SG-O/MiniFeedPlugBoard_6-13/README.MD

# Mainboard for automated SMT Feeder system #

## Documentation ##

You can find the manufacturing documentation [here.](https://github.com/SG-O/MiniFeedPlugBoard_6-13/tree/master/Doc)

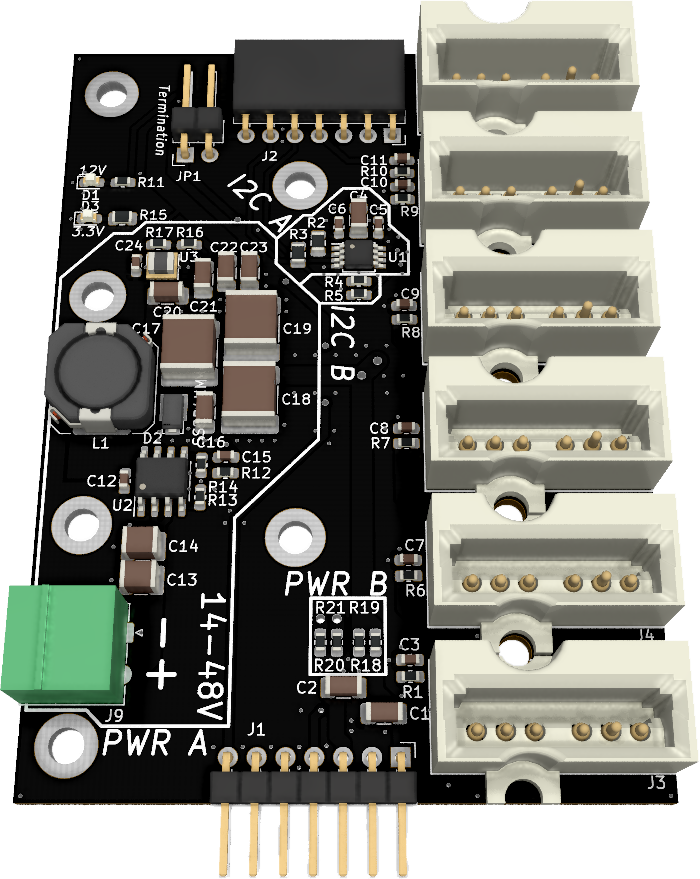
[picture p1: Doc/MiniFeedPlugBoard1.png]
