SG-O/MiniFeedPlugBoard_6-13/Doc/README.MD

# Manufacturing Documentation #

## Schematic ##

You can view the schematic [here.](https://github.com/SG-O/MiniFeedPlugBoard_6-13/blob/master/Doc/MiniFeedPlugBoard.pdf "Schematic")

## Gerber Files ##

Gerber files for this board can be found [here.](https://github.com/SG-O/MiniFeedPlugBoard_6-13/releases "Releases")

## BOM ##

The BOM **without** the power injection circuit and **without** the I2C repeater populated is available [here.](https://github.com/SG-O/MiniFeedPlugBoard_6-13/blob/master/Doc/MiniFeedPlugBoardBOM_pwr_b,i2c_b.csv "No CAN BOM")

The BOM **with** the power injection circuit and **without** the I2C repeater populated is available [here.](https://github.com/SG-O/MiniFeedPlugBoard_6-13/blob/master/Doc/MiniFeedPlugBoardBOM_pwr_a,i2c_b.csv "No CAN BOM")

The BOM **without** the power injection circuit and **with** the I2C repeater populated is available [here.](https://github.com/SG-O/MiniFeedPlugBoard_6-13/blob/master/Doc/MiniFeedPlugBoardBOM_pwr_b,i2c_a.csv "No CAN BOM")

The BOM **with** the power injection circuit and **with** the I2C repeater populated is available [here.](https://github.com/SG-O/MiniFeedPlugBoard_6-13/blob/master/Doc/MiniFeedPlugBoardBOM_pwr_a,i2c_a.csv "No CAN BOM")

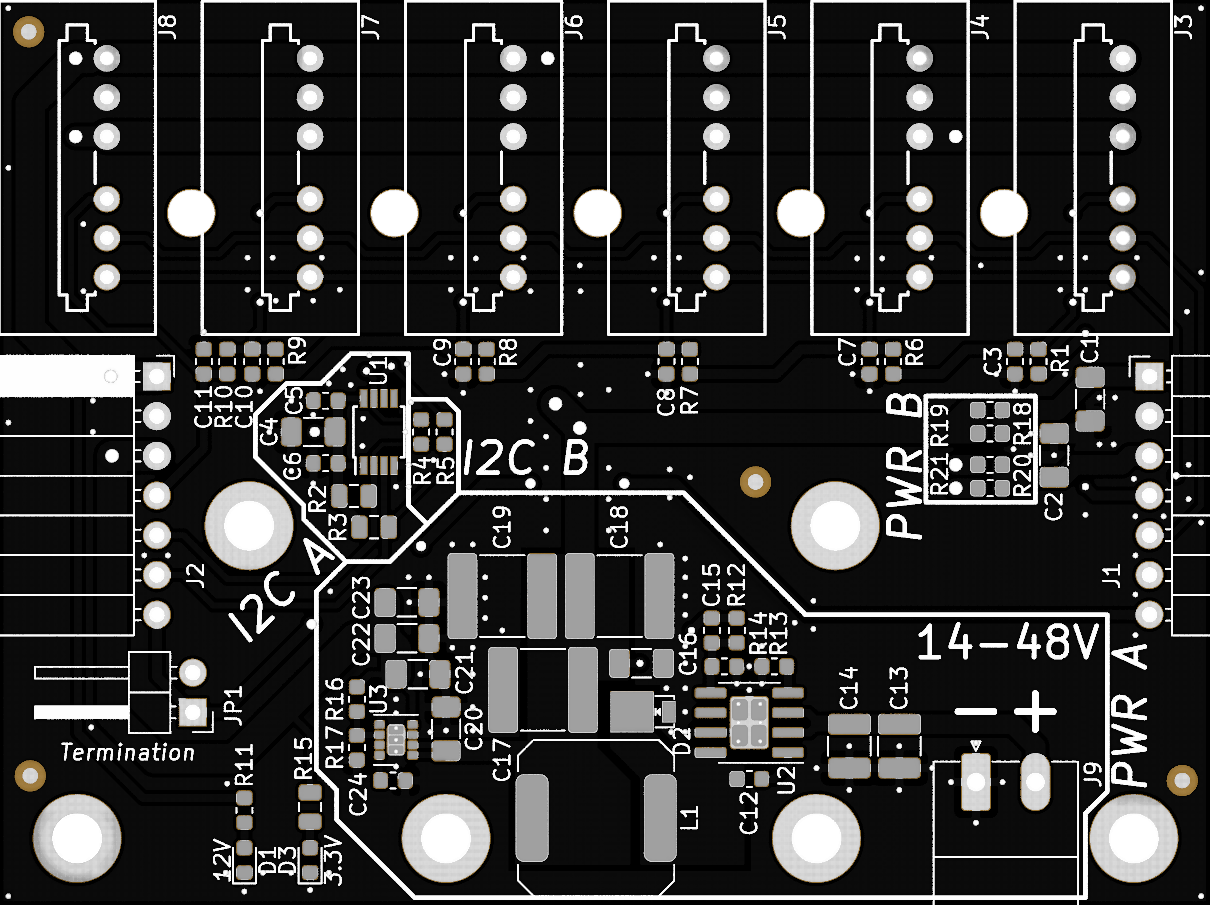
[picture p2: Doc/MiniFeedPlugBoardFront.png]
