SG-O/MiniFeedPlugBoard_6-13/Doc/MiniFeedPlugBoardBack.png

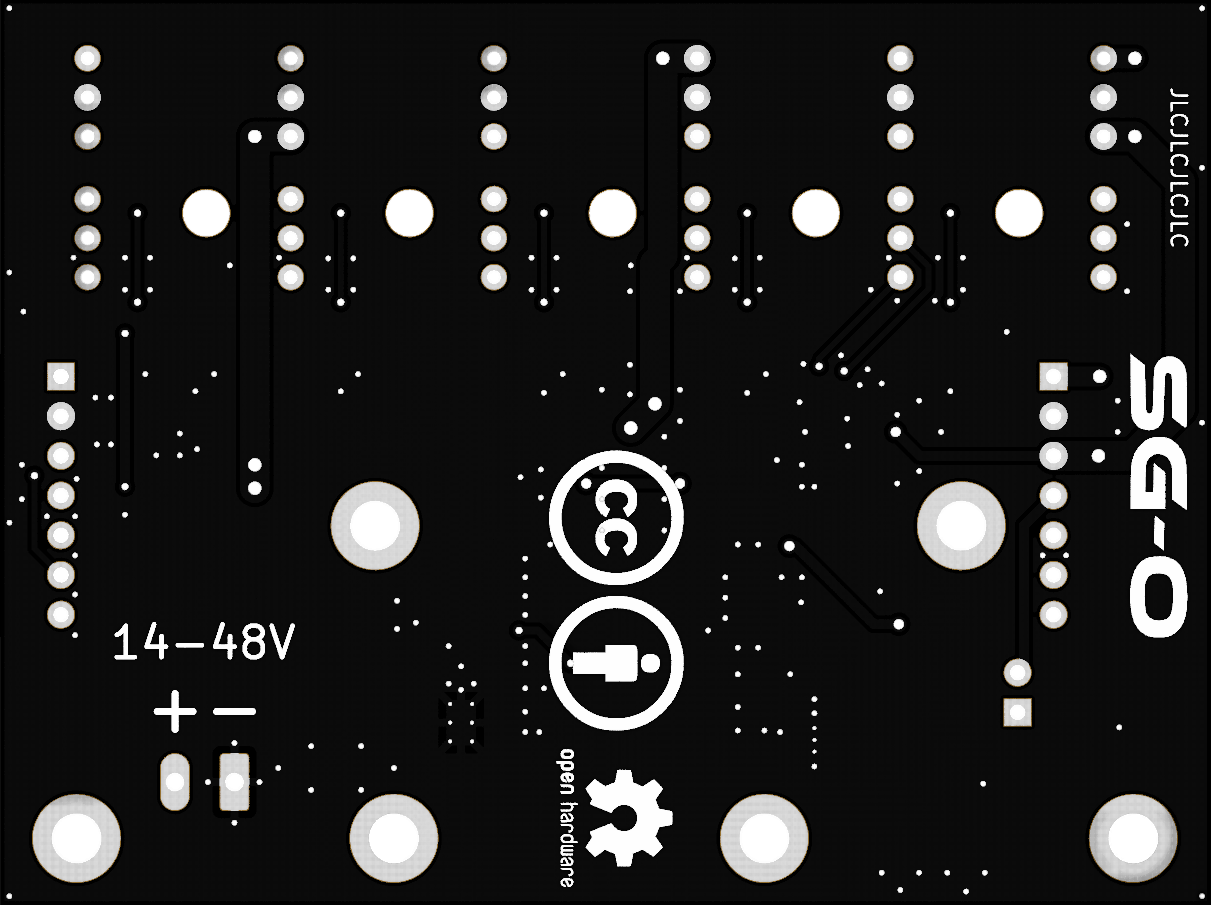
Doc/MiniFeedPlugBoardBack.png
