SG-O/MiniFeedPlugBoard_6-13/Doc/MiniFeedPlugBoard.pdf

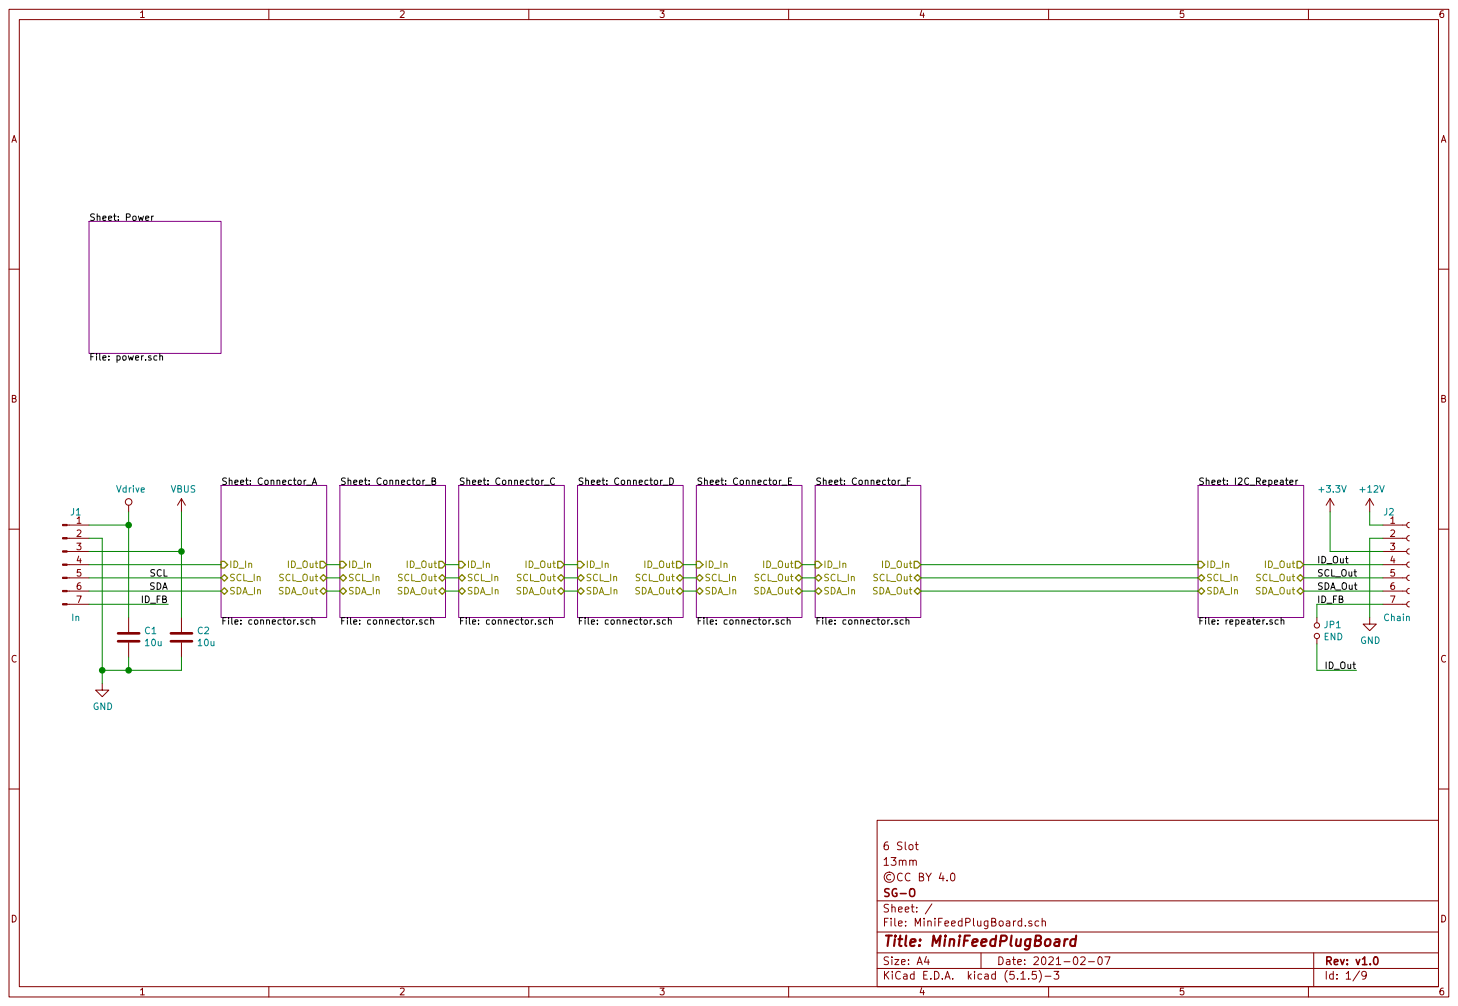
[picture p4: page 1]

File: MiniFeedPlugBoard.sch Sheet: / SG-O

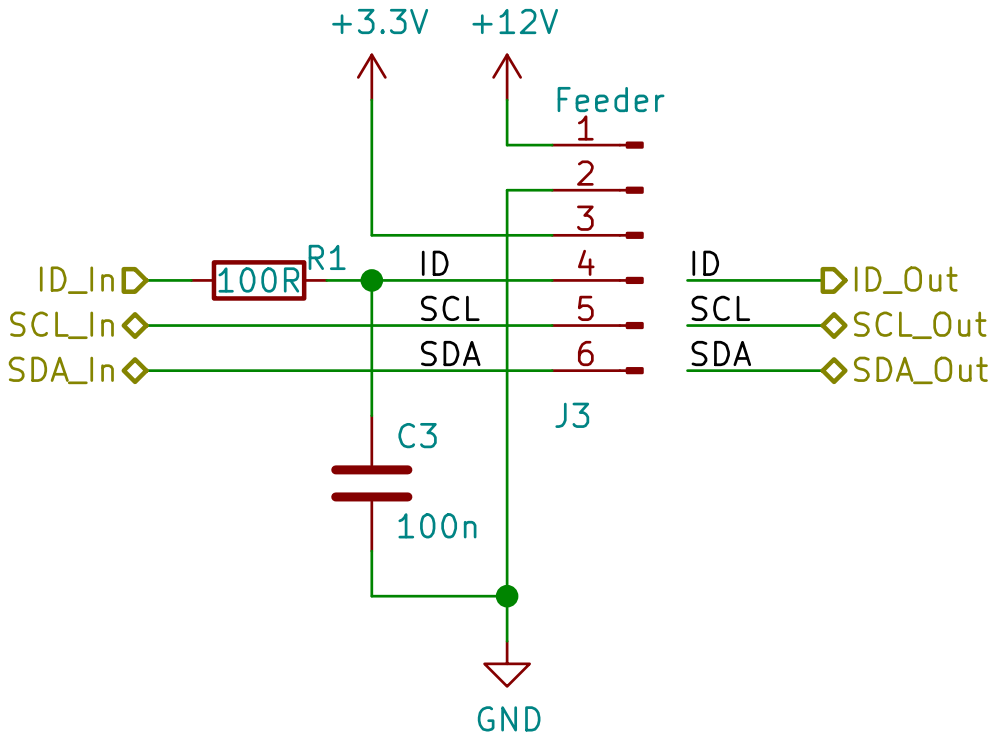
[picture p5: page 2]

File: connector.sch Sheet: /Connector_A/ SG-O

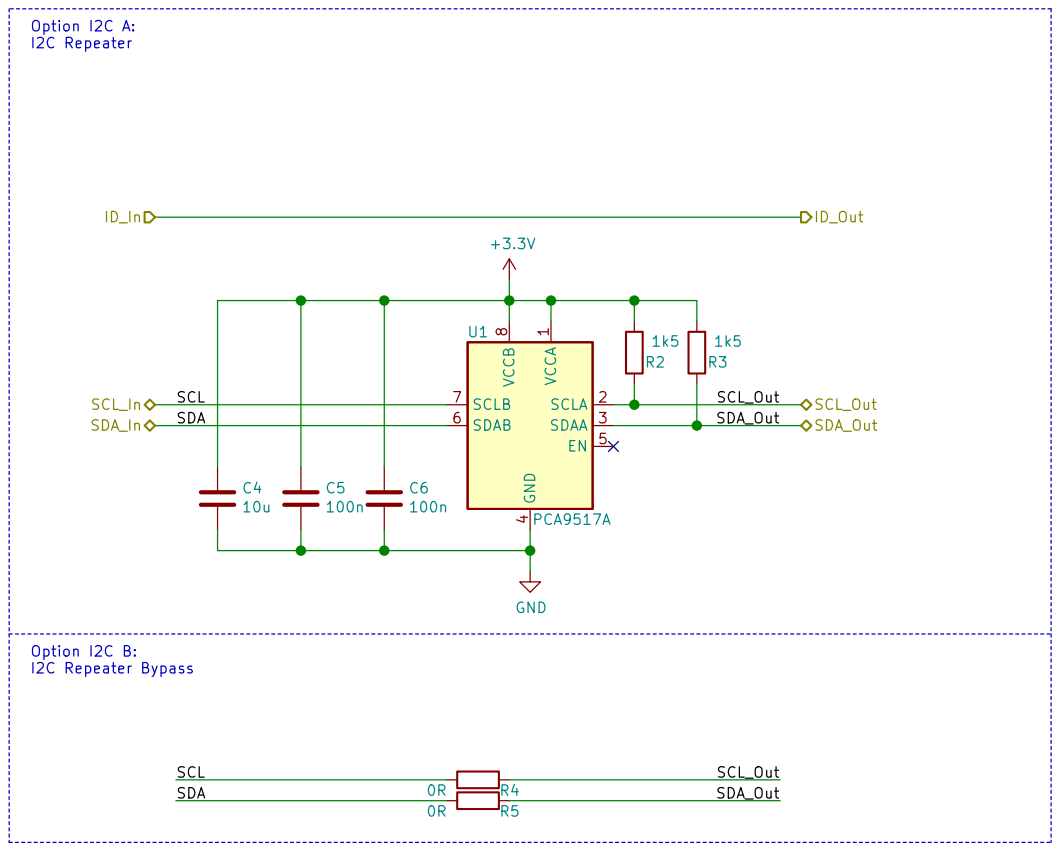
[picture p6: page 3]

4 EN 5 SDAB 6 SCLB 7 VCCB U1 8 PCA9517A

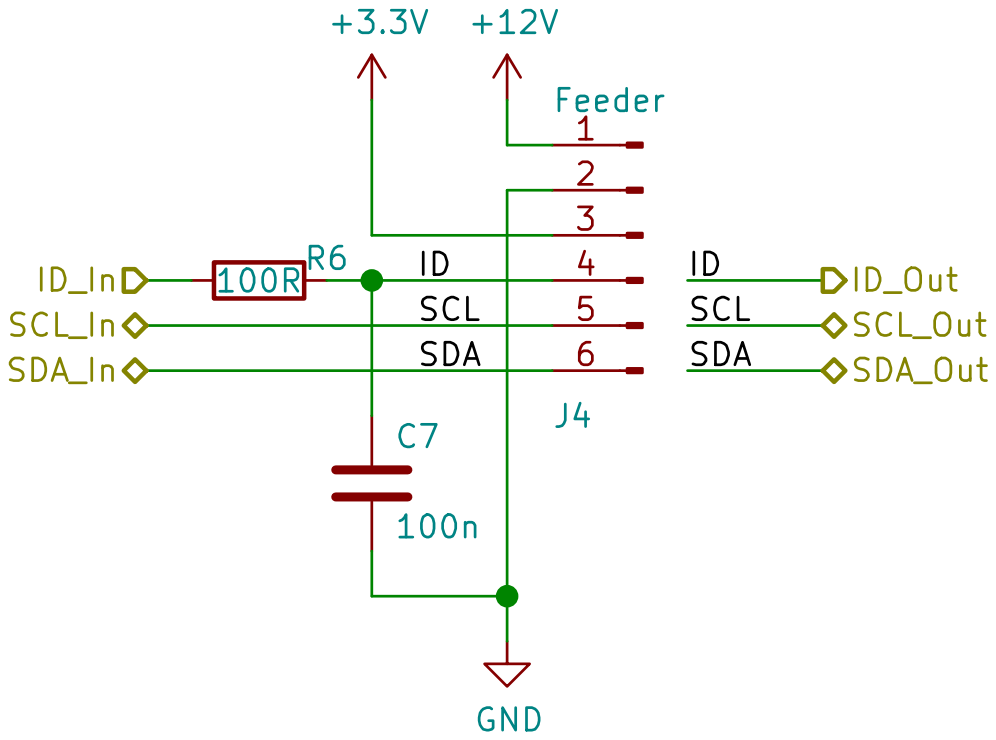
[picture p7: page 4]

File: connector.sch Sheet: /Connector_B/ SG-O

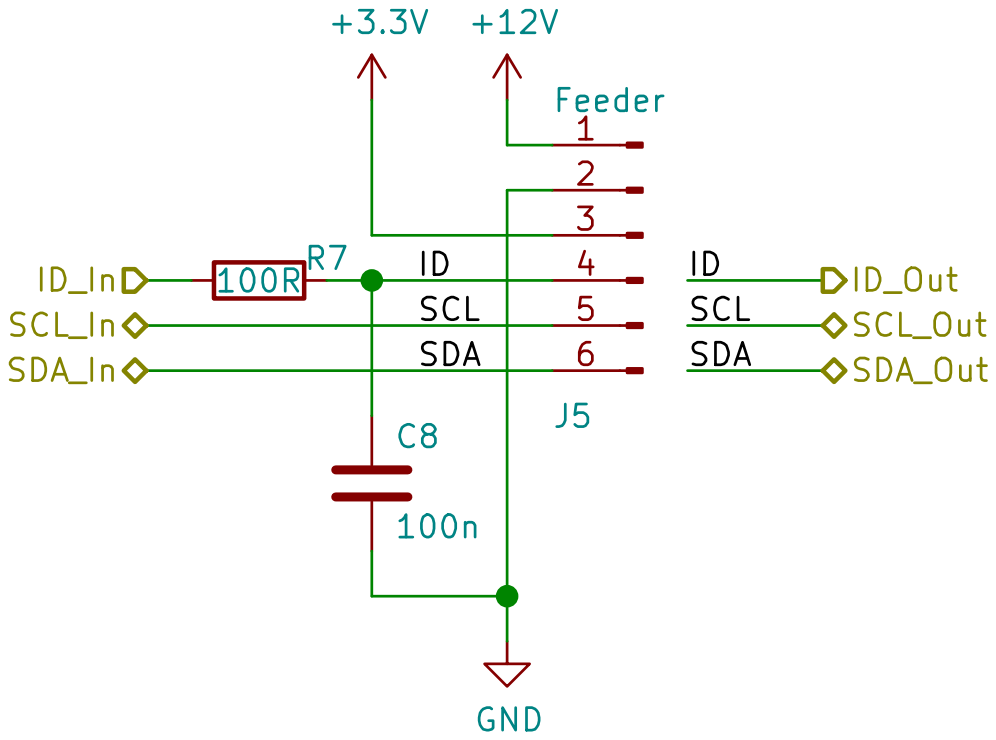
[picture p8: page 5]

File: connector.sch Sheet: /Connector_C/ SG-O

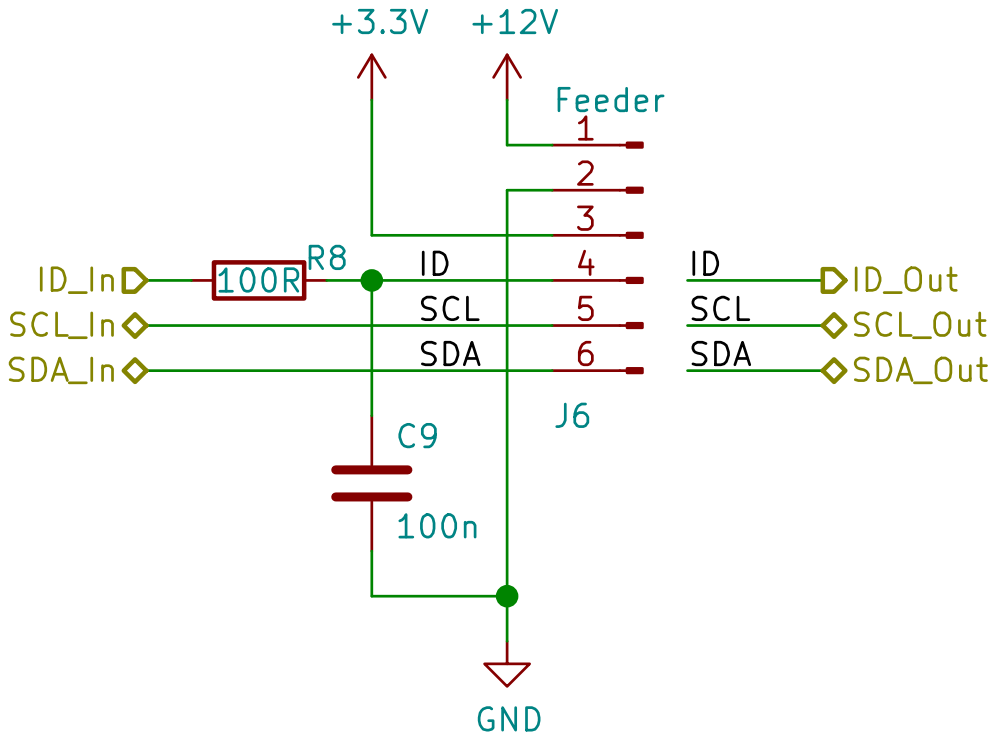
[picture p9: page 6]

File: connector.sch Sheet: /Connector_D/ SG-O

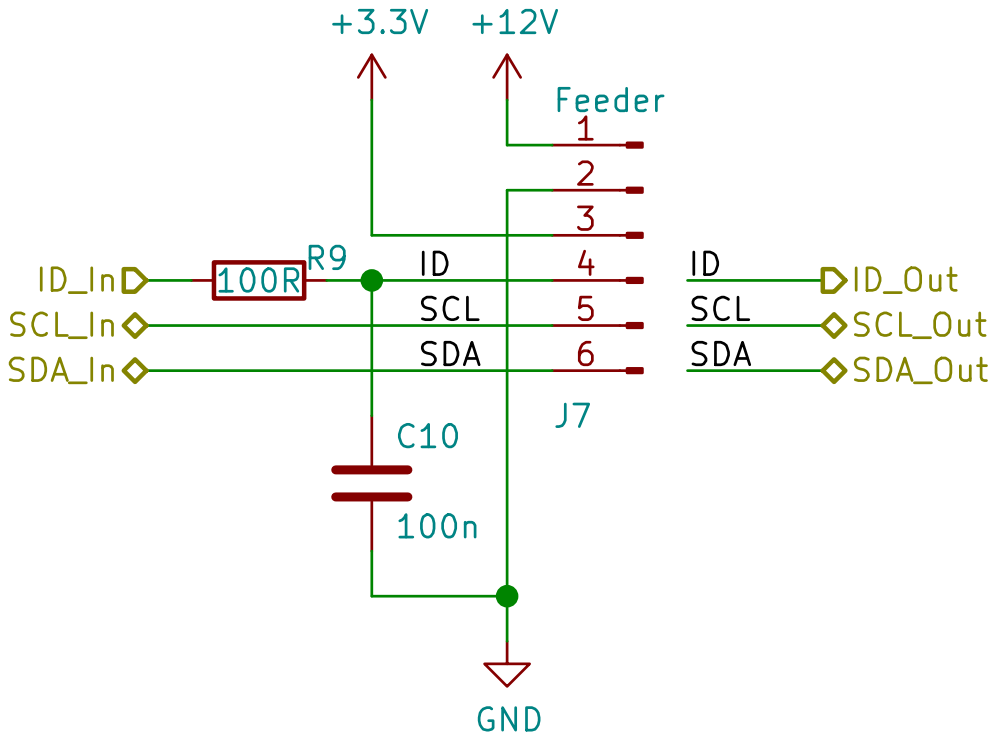
[picture p10: page 7]

File: connector.sch Sheet: /Connector_E/ SG-O

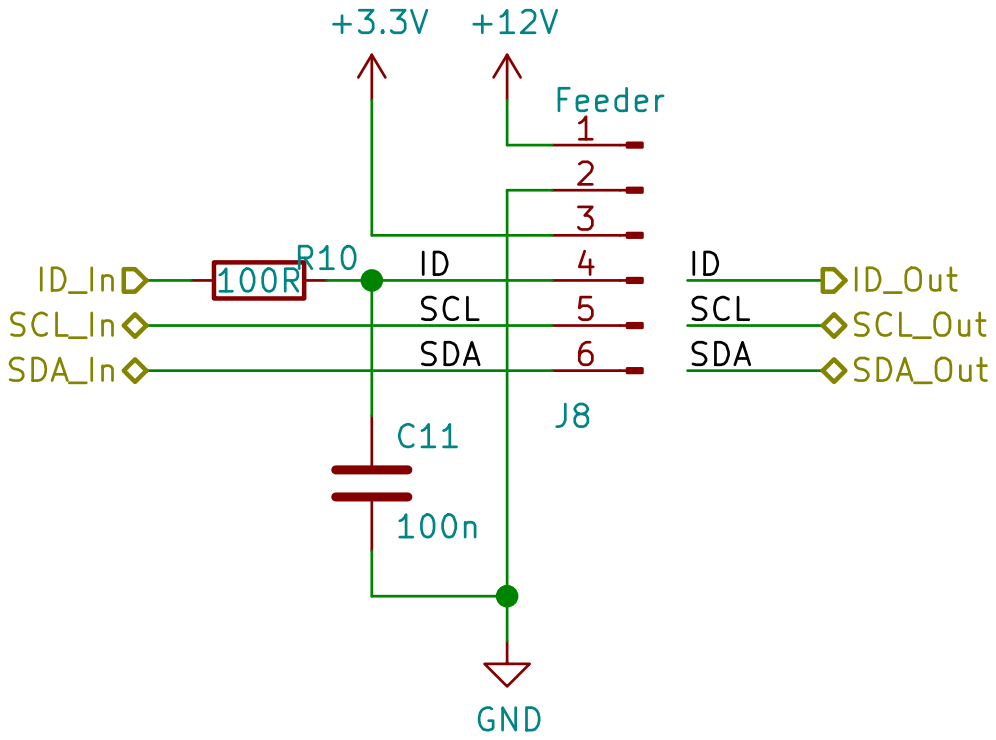
[picture p11: page 8]

File: connector.sch Sheet: /Connector_F/ SG-O

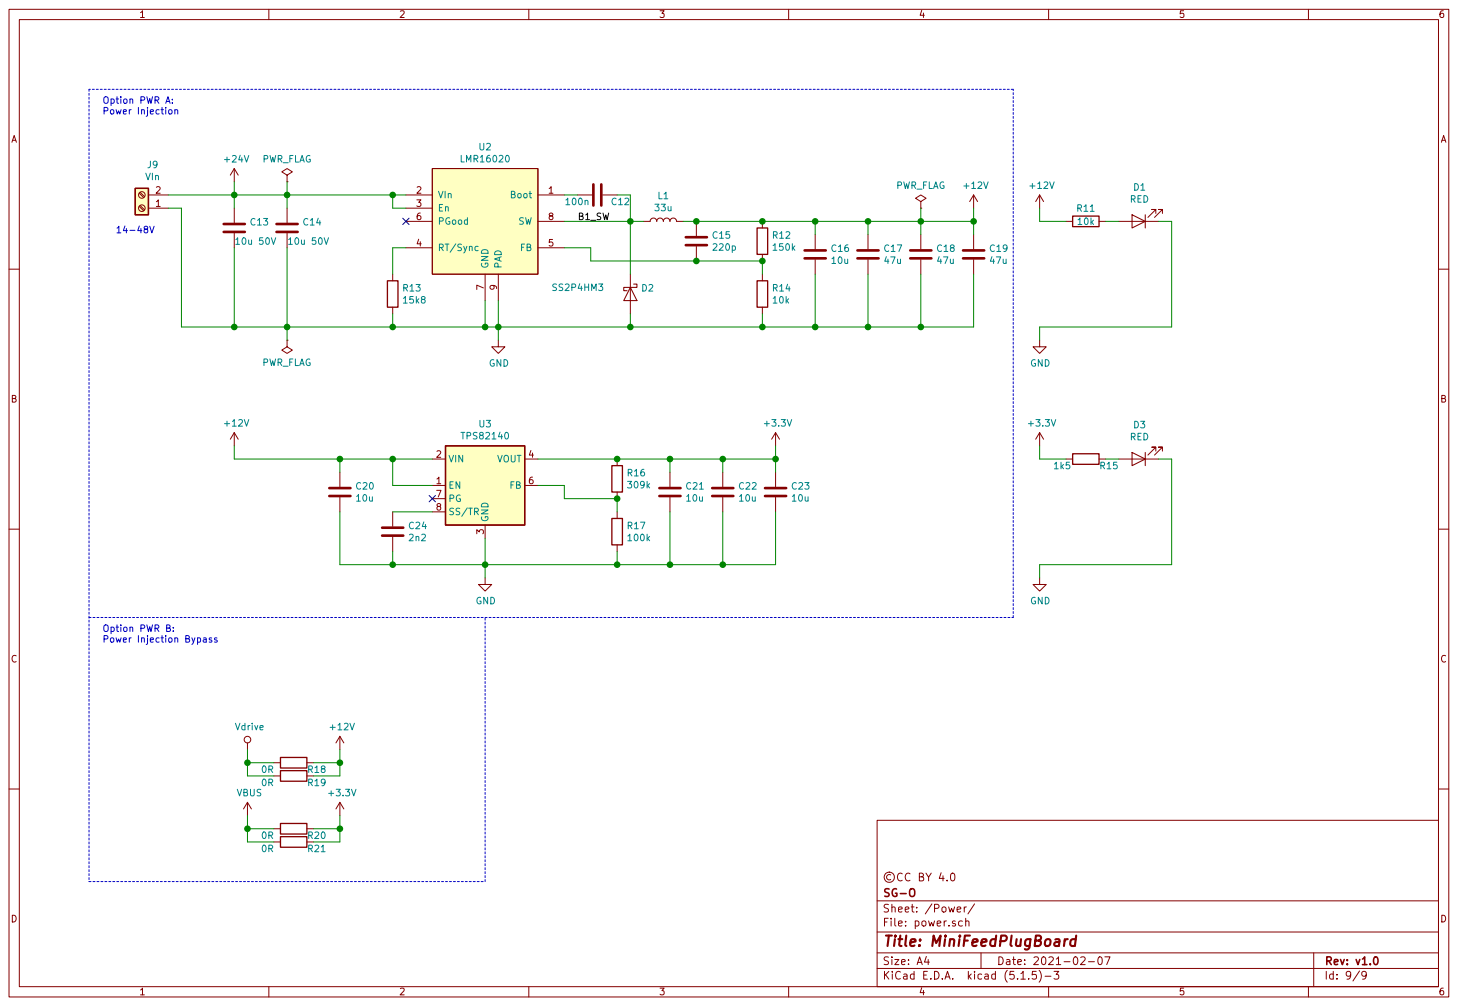
[picture p12: page 9]

3 VOUT 4 FB 6 PG 7 SS/TR 8 U3 TPS82140 C16

File: power.sch Sheet: /Power/ SG-O
