SG-O/MiniFeedPlugBoard_6-13/MiniFeedPlugBoard.kicad_pcb

## KiCad design MiniFeedPlugBoard.kicad_pcb (2021-02-06)

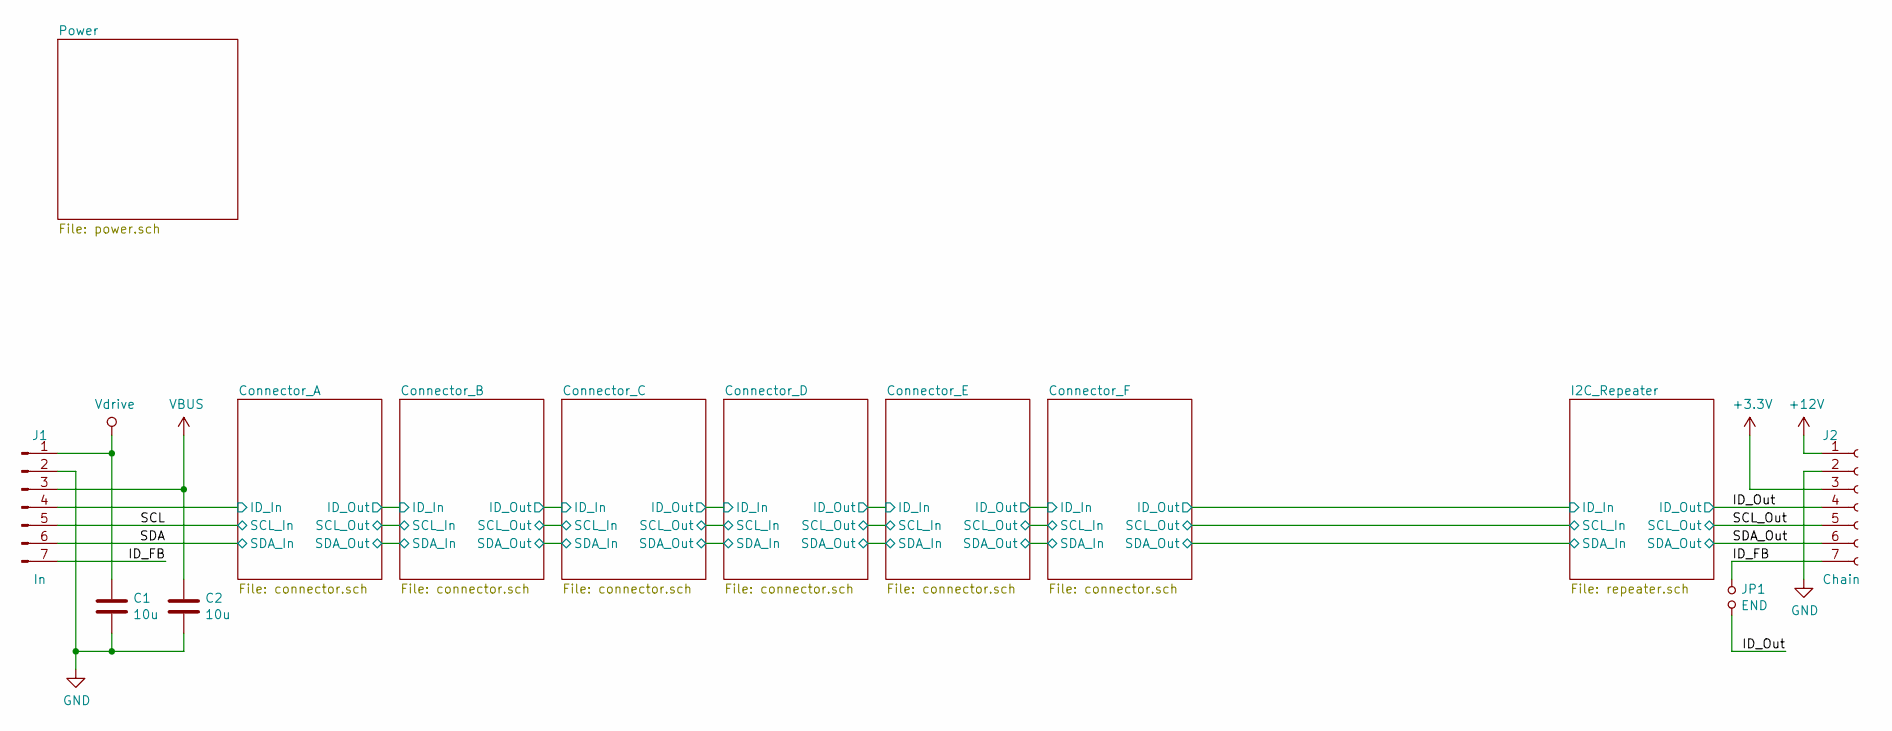
[picture p13: schematic MiniFeedPlugBoard.sch]

Parts:
C1, C2: 10u; C_1206_3216Metric; lcsc# C14860
J1: In; PinHeader_1x07_P2.54mm_Horizontal; lcsc# C376125
J2: Chain; PinSocket_1x07_P2.54mm_Horizontal; lcsc# C225515
JP1: END; PinHeader_1x02_P2.54mm_Horizontal; lcsc# C376120;C5305

Connections:
+3V3: J2.3; also elsewhere on the board
+12V: J2.1; also elsewhere on the board
/Connector_A/ID_In: J1.4; also elsewhere on the board
/ID_FB: J1.7, J2.7, JP1.1
/ID_Out: J2.4, JP1.2; also elsewhere on the board
/SCL: J1.5; also elsewhere on the board
/SCL_Out: J2.5; also elsewhere on the board
/SDA: J1.6; also elsewhere on the board
/SDA_Out: J2.6; also elsewhere on the board
GND: C1.1, C2.1, J1.2, J2.2; also elsewhere on the board
VBUS: C2.2, J1.3; also elsewhere on the board
Vdrive: C1.2, J1.1; also elsewhere on the board

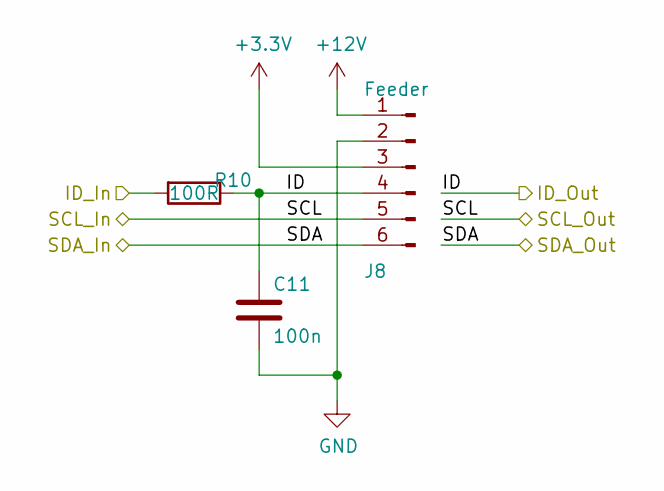
[picture p14: schematic connector.sch, MiniFeedPlugBoard]

Parts:
C3: 100n; C_0603_1608Metric; lcsc# C1591
J3: Feeder; PogoEdgeConnector
R1: 100R; R_0603_1608Metric; lcsc# C217683

Connections:
+3V3: J3.3; also elsewhere on the board
+12V: J3.1; also elsewhere on the board
/Connector_A/ID_In: R1.2; also elsewhere on the board
/Connector_B/ID_In: C3.2, J3.4, R1.1; also elsewhere on the board
/SCL: J3.5; also elsewhere on the board
/SDA: J3.6; also elsewhere on the board
GND: C3.1, J3.2; also elsewhere on the board

Parts of its further copies:
C7, C8, C9, C10, C11, C25, C26: 100n; C_0603_1608Metric; lcsc# C1591
J4, J5, J6, J7, J8, J10, J11: Feeder; PogoEdgeConnector
R6, R7, R8, R9, R10, R22, R23: 100R; R_0603_1608Metric; lcsc# C217683

Connections of its further copies:
+3V3: J4.3, J5.3, J6.3, J7.3, J8.3; also elsewhere on the board
+12V: J4.1, J5.1, J6.1, J7.1, J8.1; also elsewhere on the board
/Connector_B/ID_In: R6.2; also elsewhere on the board
/Connector_C/ID_In: C7.2, J4.4, R6.1, R7.2
/Connector_D/ID_In: C8.2, J5.4, R7.1, R8.2
/Connector_E/ID_In: C9.2, J6.4, R8.1, R9.2
/Connector_F/ID_In: C10.2, J7.4, R9.1, R10.2
/ID_Out: C11.2, J8.4, R10.1; also elsewhere on the board
/SCL: J4.5, J5.5, J6.5, J7.5, J8.5; also elsewhere on the board
/SDA: J4.6, J5.6, J6.6, J7.6, J8.6; also elsewhere on the board
GND: C7.1, C8.1, C9.1, C10.1, C11.1, J4.2, J5.2, J6.2, J7.2, J8.2; also elsewhere on the board

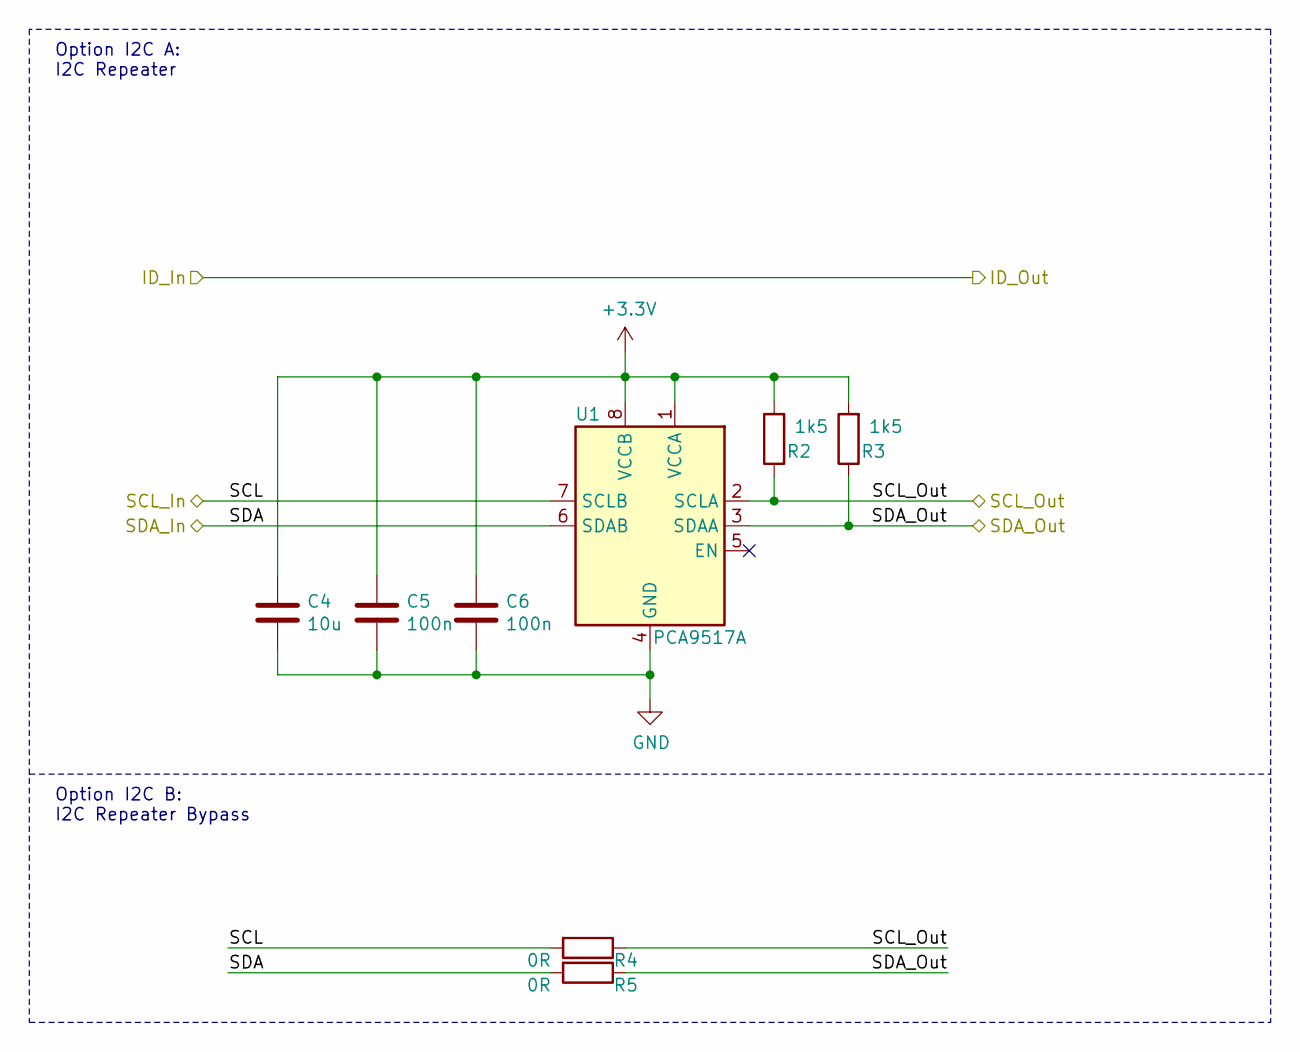
[picture p15: schematic repeater.sch, MiniFeedPlugBoard]

Parts:
C4: 10u; C_1206_3216Metric; lcsc# C14860
C5, C6: 100n; C_0603_1608Metric; lcsc# C1591
R2, R3: 1k5; R_0805_2012Metric; lcsc# C118217
R4, R5: 0R; R_0603_1608Metric; lcsc# C163836
U1: PCA9517A; TSSOP-8_3x3mm_P0.65mm; lcsc# C80799

Connections:
+3V3: C4.2, C5.2, C6.2, R2.2, R3.2, U1.1 (VCCA), U1.8 (VCCB); also elsewhere on the board
/SCL: R4.2, U1.7 (SCLB); also elsewhere on the board
/SCL_Out: R2.1, R4.1, U1.2 (SCLA); also elsewhere on the board
/SDA: R5.2, U1.6 (SDAB); also elsewhere on the board
/SDA_Out: R3.1, R5.1, U1.3 (SDAA); also elsewhere on the board
GND: C4.1, C5.1, C6.1, U1.4 (GND); also elsewhere on the board

Notes on the sheet:
Option I2C A: I2C Repeater
Option I2C B: I2C Repeater Bypass

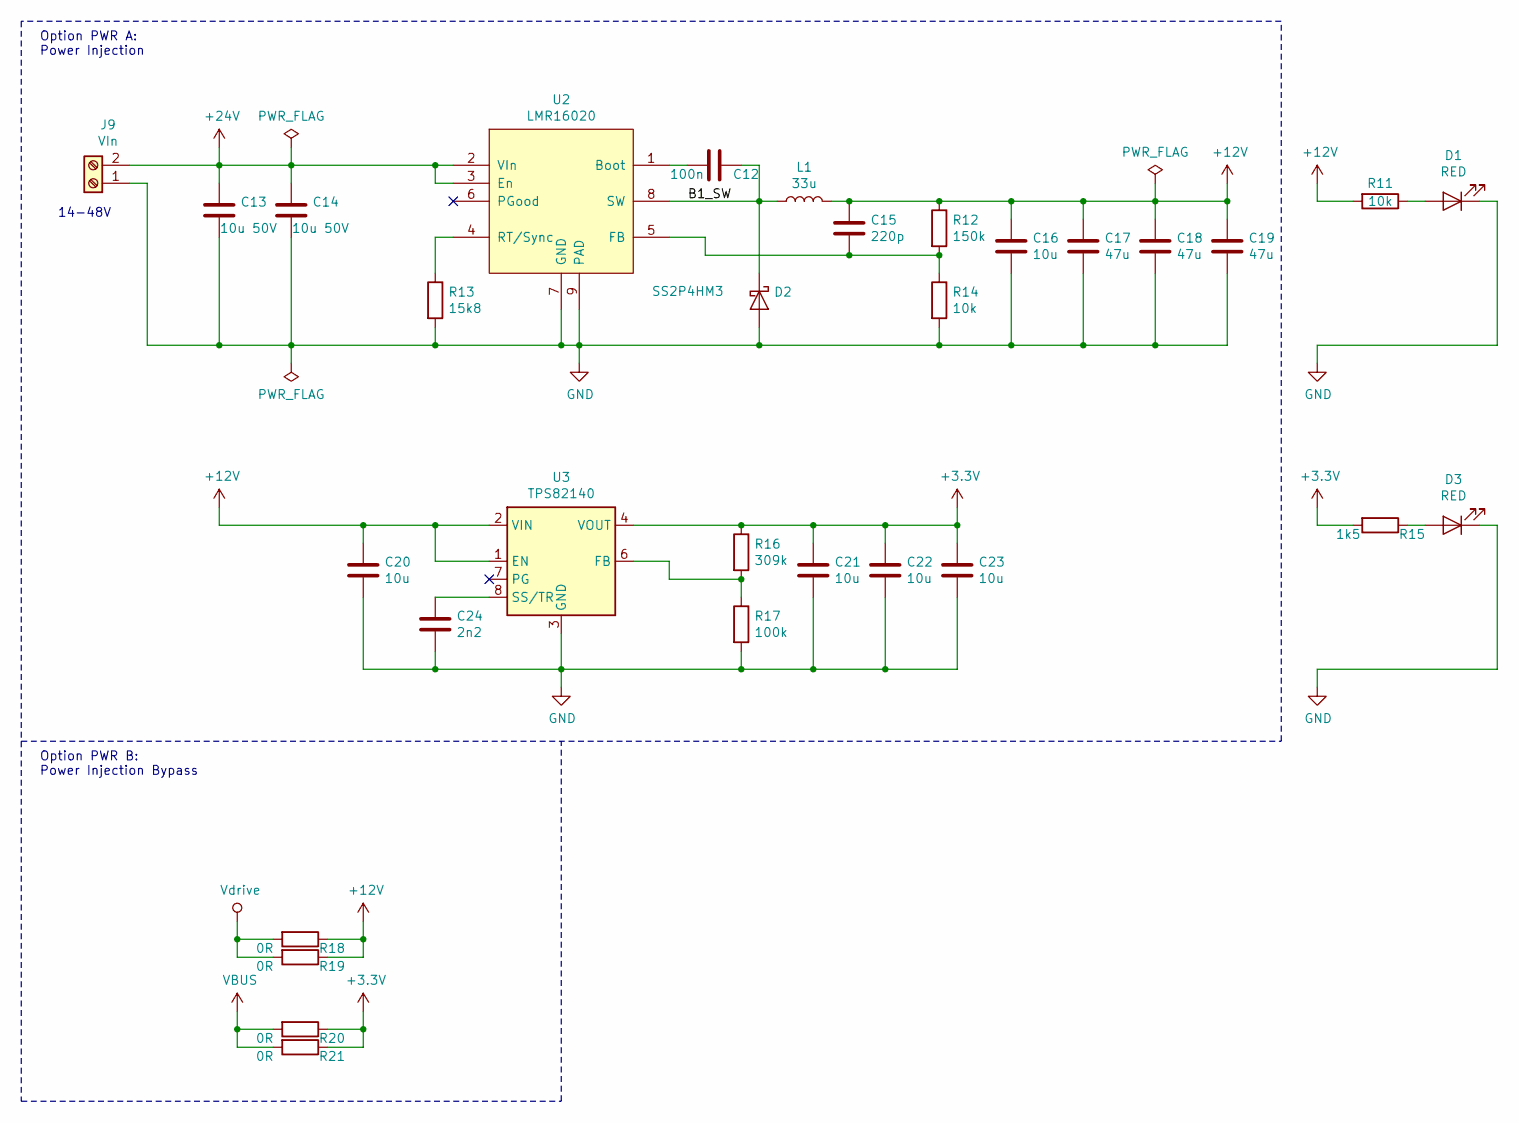
[picture p16: schematic power.sch, MiniFeedPlugBoard]

Parts:
C12: 100n; C_0603_1608Metric; lcsc# C1591
C13, C14: 10u 50V; C_1210_3225Metric; lcsc# C337485
C15: 220p; C_0603_1608Metric; lcsc# C27675
C16, C20, C21, C22, C23: 10u; C_1206_3216Metric; lcsc# C14860
C17, C18, C19: 47u; C_2220_5650Metric; lcsc# C342293
C24: 2n2; C_0603_1608Metric; lcsc# C16033
D1, D3: RED; LED_0603_1608Metric; lcsc# C118330
D2: SS2P4HM3; DO-220AA; lcsc# C467996
J9: VIn; PhoenixContact_MC_1,5_2-G-3.81_1x02_P3.81mm_Horizontal; lcsc# C8387;C8466
L1: 33u; Inductor10x10mm; lcsc# C253612
R11, R14: 10k; R_0603_1608Metric; lcsc# C128781
R12: 150k; R_0603_1608Metric; lcsc# C311920
R13: 15k8; R_0603_1608Metric; lcsc# C149924
R15: 1k5; R_0805_2012Metric; lcsc# C118217
R16: 309k; R_0603_1608Metric; lcsc# C56054
R17: 100k; R_0603_1608Metric; lcsc# C133733
R18, R19, R20, R21: 0R; R_0603_1608Metric; lcsc# C163836
U2: LMR16020; SOIC-8-1EP_3.9x4.9mm_P1.27mm_EP2.41x3.3mm_ThermalVias; lcsc# C190006
U3: TPS82140; Texas_SIL0008D_MicroSiP-8-1EP_2.8x3mm_P0.65mm_EP1.1x1.9mm_T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; lcsc# C544385

Connections:
+3V3: C21.1, C22.1, C23.1, R15.2, R16.1, R20.1, R21.1, U3.4 (VOUT), U3.5 (VOUT); also elsewhere on the board
+12V: C15.1, C16.1, C17.1, C18.1, C19.1, C20.1, L1.2, R11.2, R12.1, R18.1, R19.1, U3.1 (EN), U3.2 (VIN); also elsewhere on the board
+24V: C13.1, C14.1, J9.2, U2.2 (VIn), U2.3 (En)
/Power/B1_SW: C12.1, D2.1 (K), L1.1, U2.8 (SW)
GND: C13.2, C14.2, C16.2, C17.2, C18.2, C19.2, C20.2, C21.2, C22.2, C23.2, C24.2, D1.1 (K), D2.2 (A), D3.1 (K), J9.1, R13.2, R14.2, R17.2, U2.7 (GND), U2.9 (PAD), U3.3 (GND), U3.9 (GND); also elsewhere on the board
unnamed: C12.2, U2.1 (Boot)
unnamed: C15.2, R12.2, R14.1, U2.5 (FB)
unnamed: C24.1, U3.8 (SS/TR)
unnamed: D1.2 (A), R11.1
unnamed: D3.2 (A), R15.1
unnamed: R13.1, U2.4 (RT/Sync)
unnamed: R16.2, R17.1, U3.6 (FB)
VBUS: R20.2, R21.2; also elsewhere on the board
Vdrive: R18.2, R19.2; also elsewhere on the board

Notes on the sheet:
14-48V
Option PWR B: Power Injection Bypass
Option PWR A: Power Injection

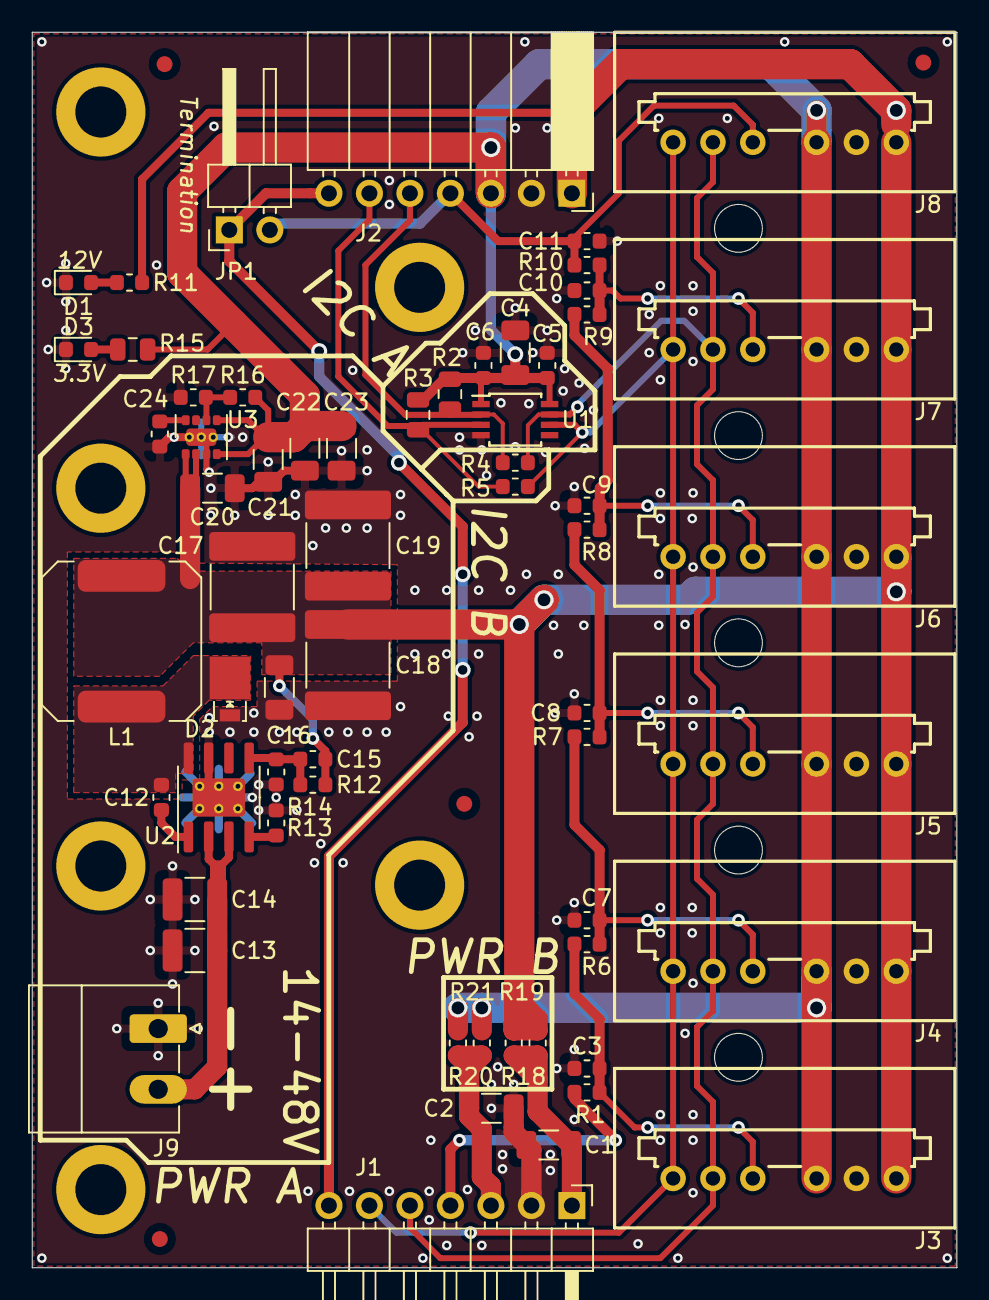
[picture p17: board MiniFeedPlugBoard.kicad_pcb from above]

Board: 2 copper layers, 58.0 x 77.5 mm, 66 parts (0 on the bottom side), 26 nets.

Other parts of the board:
Fid1, Fid2, Fid3, Fid4: Fiducial_1mm_Mask2mm
