SG-O/MiniFeedPlugBoard_6-13/(notices)

Notices in the files:
connector.sch:
©CC BY 4.0
